KarimM-MSW/Wuerfel_Projekt/README.md

# Hardware
Siehe: [Fusion 360](https://mymsw.autodesk360.com/g/projects/20250221882367826/data/dXJuOmFkc2sud2lwcHJvZDpmcy5mb2xkZXI6Y28uNGE5Rl9pY0hUby1hNFgzeldFdEFYUQ==)
