KarimM-MSW/Wuerfel_Projekt/Projekt Wuerfel/Drahtzugliste.pdf

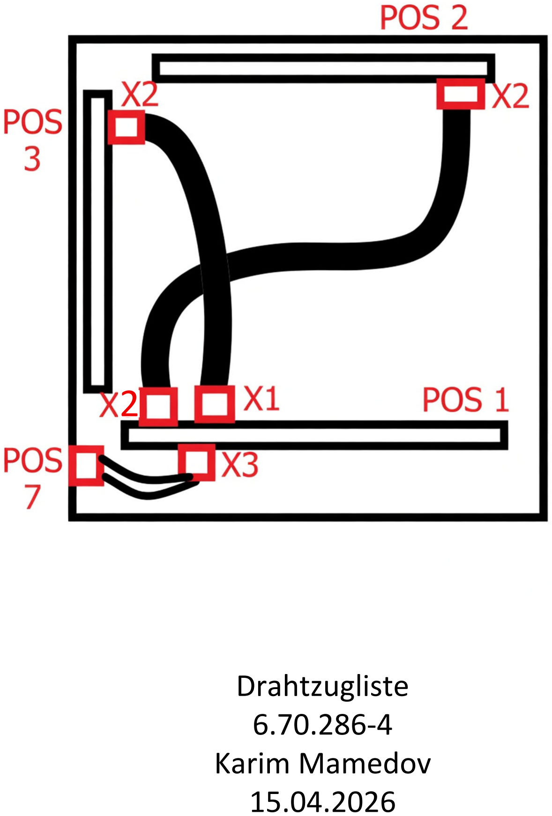
[picture p1: page 1]

Drahtzugliste
6.70.286-4
Karim Mamedov
15.04.2026

2
