KarimM-MSW/Wuerfel_Projekt/Projekt Wuerfel/Wuerfel Zusammenbau KM.pdf

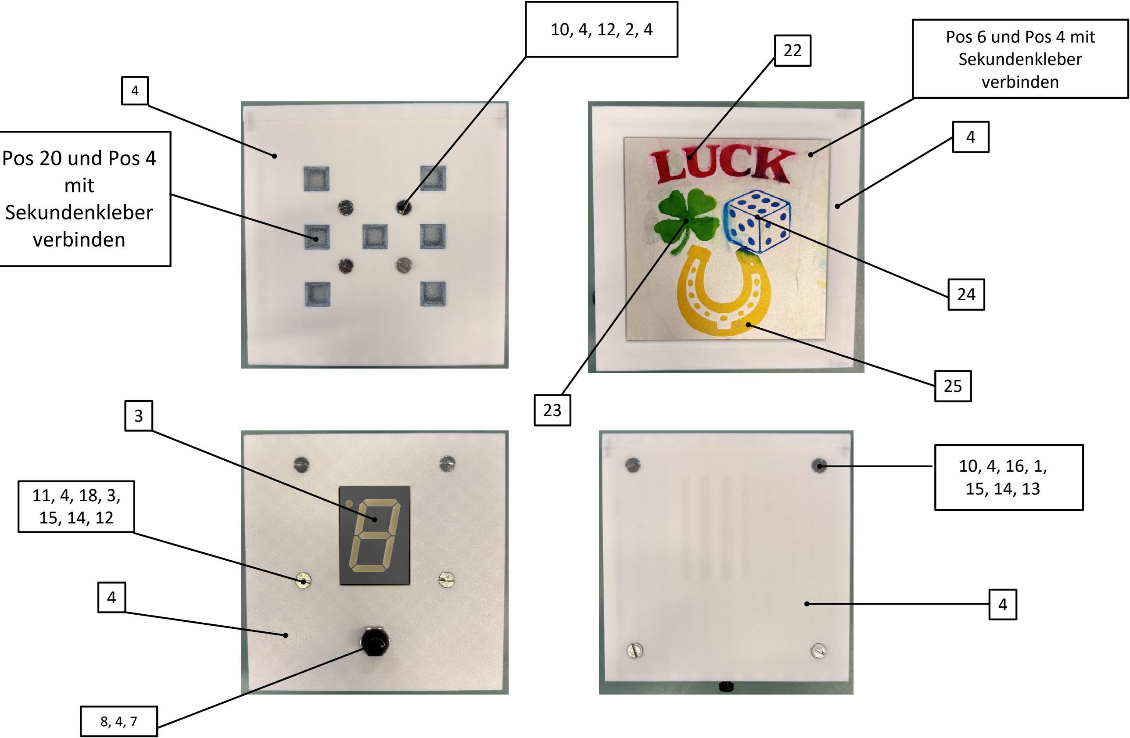
[picture p2: figure]
Pos 20 und Pos 4 mit Sekundenkleber verbinden; Pos 6 und Pos 4 mit Sekundenkleber verbinden
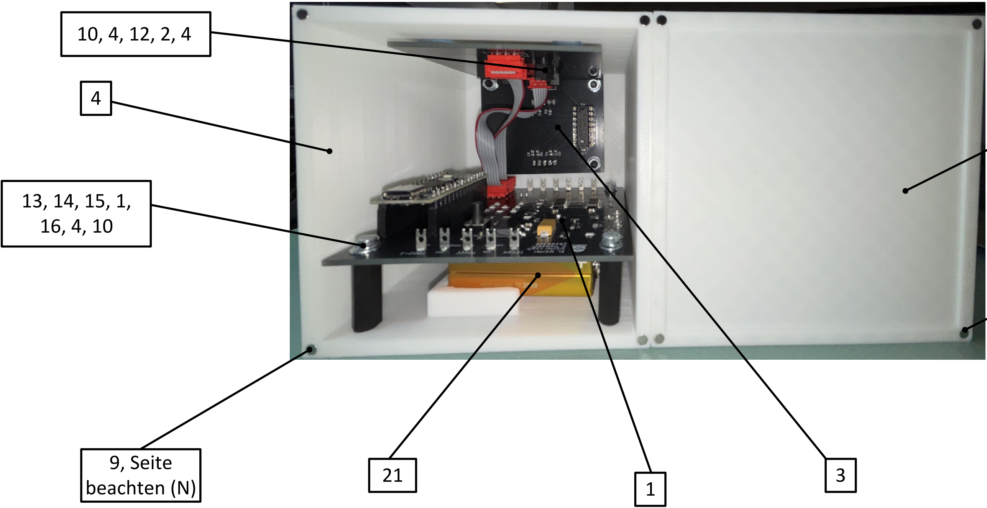
[picture p3: figure]
21 9, Seite beachten (N)

5

9, Seite
beachten (S)

# Zeichnung Zusammenbau

6.70.150-4

# Karim Mamedov

15.04.2026
