KarimM-MSW/Wuerfel_Projekt/Projekt Wuerfel/Luck.png

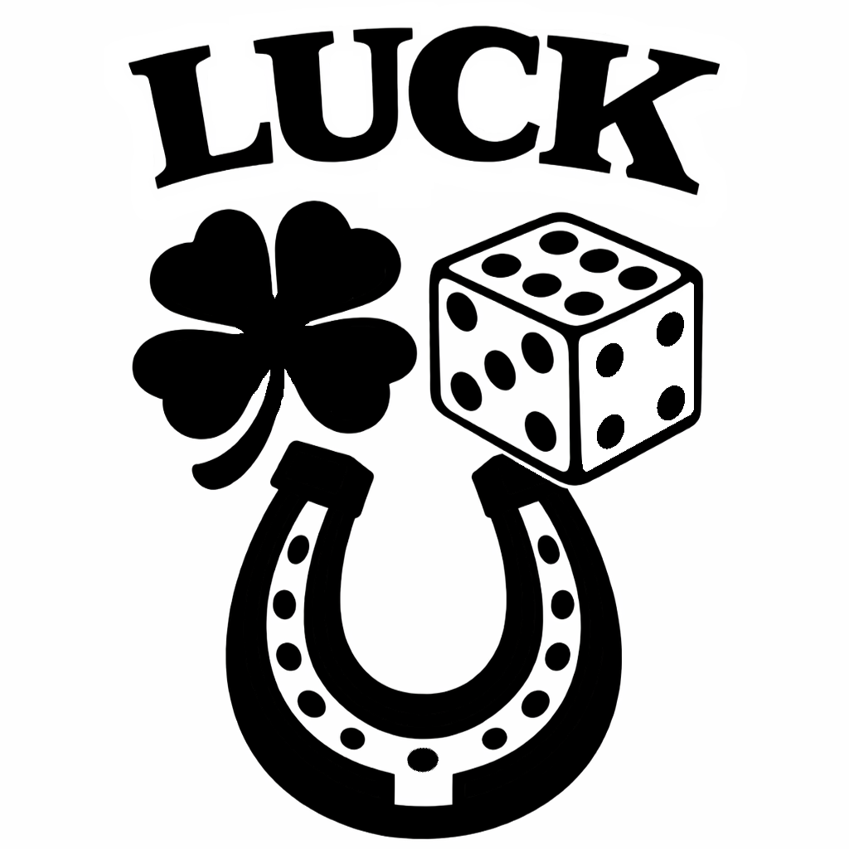
Projekt Wuerfel/Luck.png
