KarimM-MSW/Wuerfel_Projekt/Projekt Wuerfel/Mech. Zeichnung Deckel KM.jpg

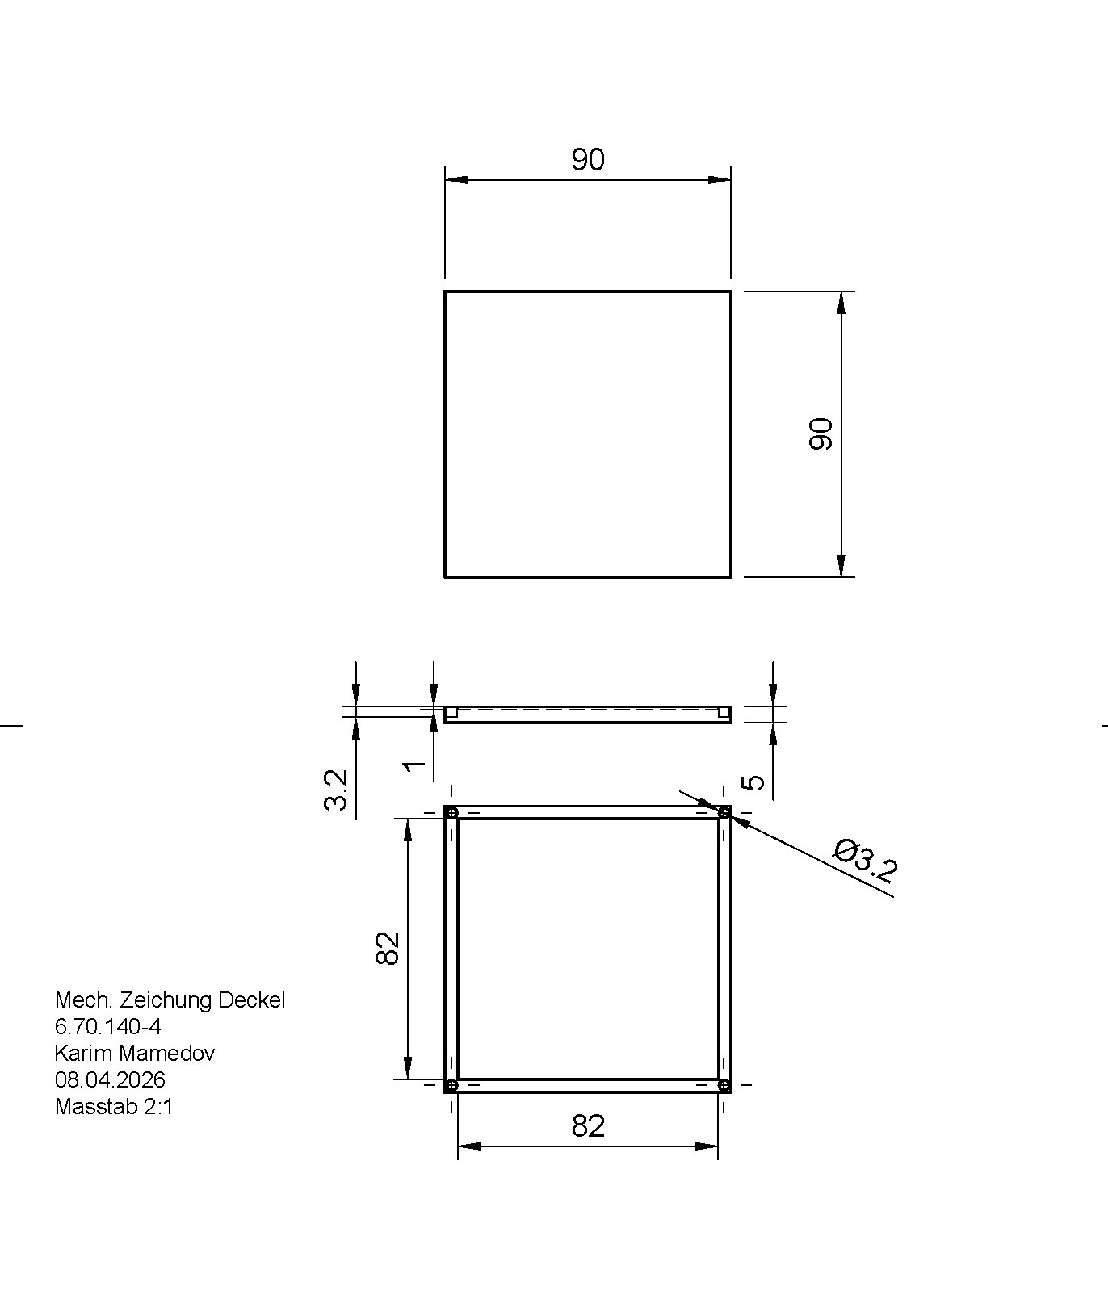
Projekt Wuerfel/Mech. Zeichnung Deckel KM.jpg
