KarimM-MSW/Wuerfel_Projekt/Projekt Wuerfel/Mech.Zeichnung Gehause KM.jpg

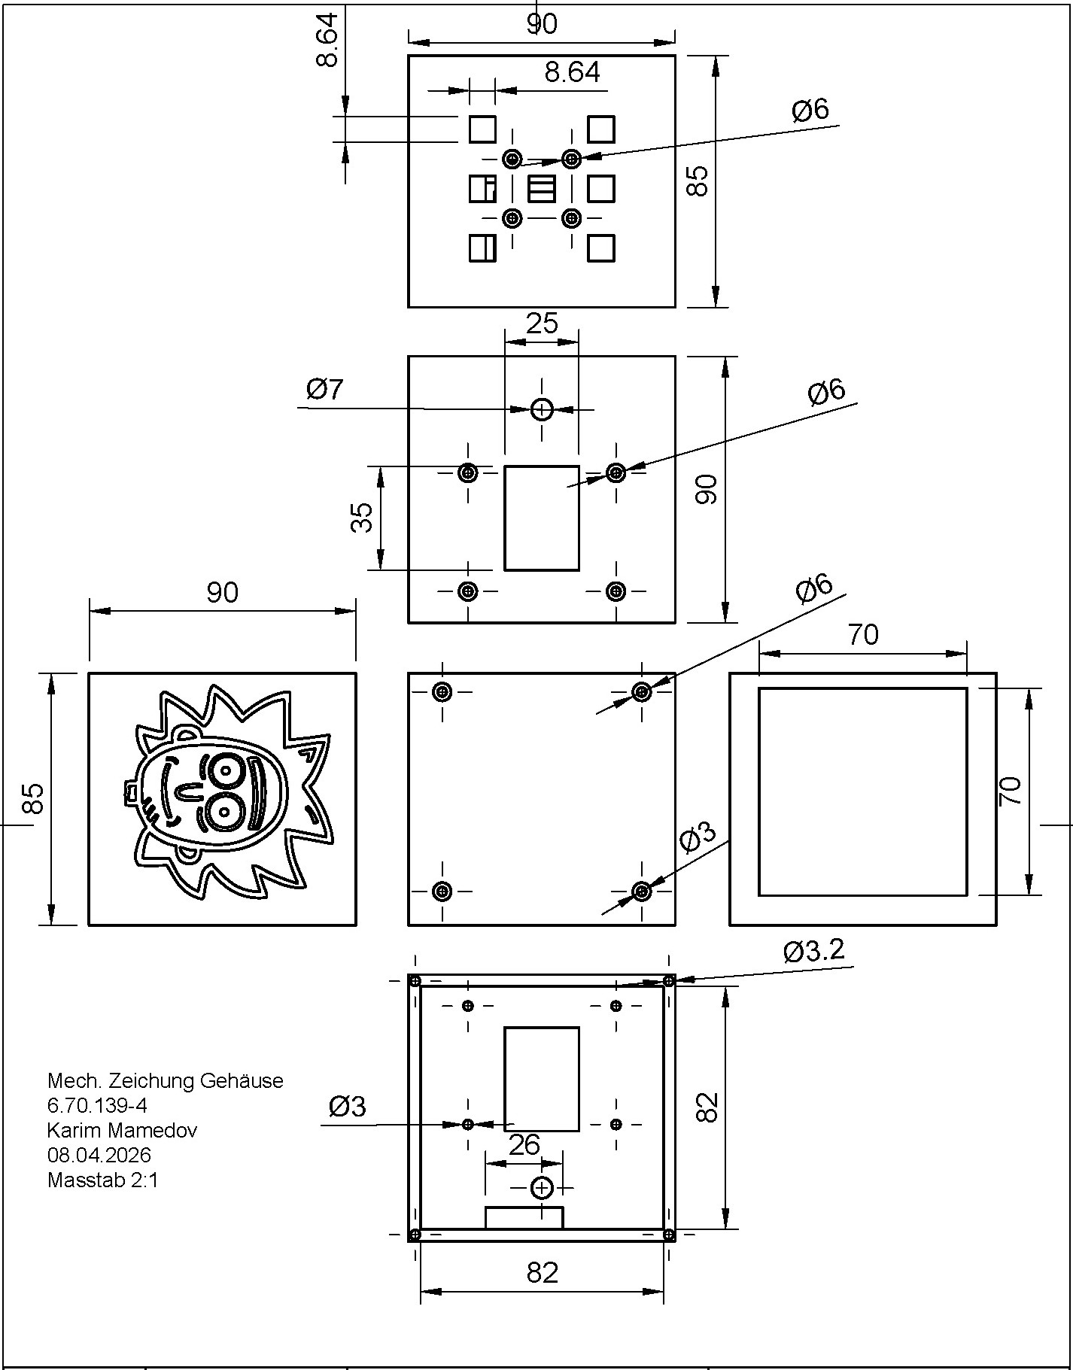
Projekt Wuerfel/Mech.Zeichnung Gehause KM.jpg
