KarimM-MSW/Wuerfel_Projekt/Projekt Wuerfel/Stückliste Zusammenbau.docx

Produkt Elektronischer Würfel | | | | | | Nummer | | Index | Mikro | Blatt/Total 1/1
Baugruppe Zusammenbau | | | | | | Stück | | Termin | | Auftrag
Erstellt 08.04.2026 Karim Mamedov | | Geändert | | | | Felder leer lassen, wird durch PPS ausgefüllt.
Geprüft | | Geprüft
Stk. | Gegenstand/Wert Zchng.Nr. | | Pos.Nr. | Zeile | Bestell-Nr./Material Lieferant | | | | | | C
1 | Mainboard bestückt | | 1 | 1 | Baugruppe A AE1 | | | | | | NT
1 | RGB board bestückt | | 2 | 2 | Baugruppe B AE1 | | | | | | NT
1 | 7Seg board bestückt | | 3 | 3 | Baugruppe C AE1 | | | | | | NT
| | | | 4
1 | Würfel Gehäuse | | 4 | 5 | AE1 | | | | | | NT
1 | Würfel Deckel | | 5 | 6 | AE1 | | | | | | NT
| | | | 7
1 | Alu platte mit Bild 69x69x0.5 mm | | 6 | 8 | AE1 | | | | | | NT
| | | | 9
1 | Taster | | 7 | 10 | AE1 | | | | | | NT
1 | Taster Mutter | | 8 | 11 | AE1 | | | | | | NT
| | | | 12
8 | Magnet Ø 3 × 3 mm | | 9 | 13 | AE1 | | | | | | NT
| | | | 14
8 | Senkschraube M3x12 | | 10 | 15 | AE1 | | | | | | NT
4 | Senkschraube M3x5 | | 11 | 16 | AE1 | | | | | | NT
12 | Mutter M3 | | 12 | 17 | AE1 | | | | | | NT
4 | Zylinderschraube M3x10 | | 13 | 18 | AE1 | | | | | | NT
8 | Federring M3 | | 14 | 19 | AE1 | | | | | | NT
8 | Unterlagscheibe M3 | | 15 | 20 | AE1 | | | | | | NT
4 | Abstandshalter M3x20 | | 16 | 21 | AE1 | | | | | | NT
4 | Abstandshalter M3x6 | | 17 | 22 | AE1 | | | | | | NT
4 | Abstandshalter M3x5 Innen/Aussen | | 18 | 23 | AE1 | | | | | | NT
| | | | 24
2 | Flachbandkabel 6 Pol 2xWR-MM Male 7cm | | 19 | 25 | AE1 | | | | | | NT
| | | | 26
7 | LED Diffusor 8.5x8.5x4 mm | | 20 | 27 | AE1 | | | | | | NT
| | | | 28
1 | Batterie 9V Block | | 21 | 29 | AE1 | | | | | | NT
1 | Farbe Rot 72 | | 22 | 30 | AE1 | | | | | | NT
1 | Farbe Grün 54 | | 23 | 31 | AE1 | | | | | | NT
1 | Farbe Blau 44 | | 24 | 32 | AE1 | | | | | | NT
1 | Farbe Gelb 62 | | 25 | 33 | AE1 | | | | | | NT
*=Preis anfragen Stückliste.doc | | | EF=Eigenfabrikat BT=Bestellteil PA=Physikartikel NT=Normteil RM=Rohmaterial
