KarimM-MSW/Wuerfel_Projekt/Projekt Wuerfel/A/Stückliste Mainboard.docx

Produkt Elektronischer Würfel | | | | | | Nummer | Index | Mikro | Blatt/Total 1/2
Baugruppe Mainboard A | | | | | | Stück | Termin | | Auftrag
Erstellt 05.03.2026 Karim Mamedov | | Geändert | | | | Felder leer lassen, wird durch PPS ausgefüllt.
Geprüft | | Geprüft
Stk. | Gegenstand/Wert Zchng.Nr. | | Pos.Nr. | Zeile | Bestell-Nr./Material Lieferant | | | | | C
1 | Schema Baugr A 6.70.136-4 | | | 1
1 | Bestückungsplan 6.70.137-4 | | | 2
1 | Bearbeitungsplan 6.70.138-4 | | | 3
| | | | 4
1 | Mainboard | | 1 | 5 | JLCPCB | | | | | BT
| | | | 6
5 | SMD Kondensator 100nF, 0805 | | C1-C3, C7, C8 | 7 | AE1 | | | | | NT
1 | SMD-Tantal - Kondensator 7343 100uF 16V | | C4 | 8 | AE1 | | | | | NT
2 | SMD Kondensator 4.7uF, 0805 | | C5, C6 | 9 | AE1 | | | | | NT
| | | | 10
1 | Arduino Nano | | K1 | 11 | AE1 | | | | | NT
1 | IC 4-bit Zähler 4161D SO16 | | K2 | 12 | AE1 | | | | | NT
1 | SMD-IC 74132D (Quad 2-input NAND schmitt trigger) SO14 | | K3 | 13 | AE1 | | | | | NT
| | | | 14
7 | SMD-LED ROT 0805 | | P1-P7 | 15 | AE1 | | | | | NT
| | | | 16
1 | SMD-PNP-Transistor BC807 SOT23 | | Q1 | 17 | AE1 | | | | | NT
1 | SMD-NPN-Transistor BC817 SOT23 | | Q2 | 18 | AE1 | | | | | NT
| | | | 19
2 | SMD-Widerstand 22kΩ/0,1W/1% 0805 | | R1, R2 | 20 | AE1 | | | | | NT
1 | SMD-Widerstand 390kΩ/0,1W/1% 0805 | | R3 | 21 | AE1 | | | | | NT
2 | SMD-Widerstand 470Ω/0,1W/1% 0805 | | R4, R9 | 22 | AE1 | | | | | NT
1 | SMD-Widerstand 1MΩ/0,1W/1% 0805 | | R5 | 23 | AE1 | | | | | NT
1 | SMD-Widerstand 750kΩ/0,1W/1% 0805 | | R6 | 24 | AE1 | | | | | NT
1 | SMD-Widerstand 10kΩ/0,1W/1% 0805 | | R7 | 25 | AE1 | | | | | NT
1 | SMD-Widerstand 68Ω/0,1W/1% 0805 | | R8 | 26 | AE1 | | | | | NT
2 | SMD-Widerstand 220Ω/0,1W/1% 0805 | | R10, R11 | 27 | AE1 | | | | | NT
4 | SMD-Diode 1N4148 SOD123 | | R12, R13, R14, R18 | 28 | AE1 | | | | | NT
1 | SMD-Diode 1N4007 SOD123 | | R15 | 29 | AE1 | | | | | NT
1 | SMD-Zener-Diode 5.1V SOD323 | | R17 | 30 | AE1 | | | | | NT
| | | | 31
1 | SMD-Taste | | S1 | 32 | AE1 | | | | | NT
| | | | 33

Produkt Elektronischer Würfel | | | | | | Nummer | | Index | Mikro | Blatt/Total 2/2
Baugruppe Mainboard A | | | | | | Stück | | Termin | | Auftrag
Erstellt 05.03.2026 Karim Mamedov | | Geändert | | | | Felder leer lassen, wird durch PPS ausgefüllt.
Geprüft | | Geprüft
Stk. | Gegenstand/Wert Zchng.Nr. | | Pos.Nr. | Zeile | Bestell-Nr./Material Lieferant | | | | | | C
1 | Spannungsregler LM7805 TO-252 | | T1 | 34 | AE1 | | | | | | NT
| | | | 35
2 | WR_MM Female Connector 6.90367E+11 | | X1, X2 | 36 | AE1 | | | | | | NT
1 | 2-Pol-Buchse B2B-XH-A | | X3 | 37 | AE1 | | | | | | NT
1 | Einzelkontakt 9V Female | | X4 | 38 | AE1 | | | | | | NT
1 | Einzelkontakt 9V Male | | X5 | 39 | AE1 | | | | | | NT
14 | Lötstift 1002M SA0785 | | X6 – X19 | 40 | AE1 | | | | | | NT
2 | Sockel 15 Pin | | X20, X21 | 41 | AE1 | | | | | | NT
| | | | 42
| | | | 43
| | | | 44
| | | | 45
| | | | 46
| | | | 47
| | | | 48
| | | | 49
| | | | 50
| | | | 51
| | | | 52
| | | | 53
| | | | 54
| | | | 55
| | | | 56
| | | | 57
| | | | 58
| | | | 59
| | | | 60
| | | | 61
| | | | 62
| | | | 63
| | | | 64
*=Preis anfragen Stückliste.doc | | | EF=Eigenfabrikat BT=Bestellteil PA=Physikartikel NT=Normteil RM=Rohmaterial
