KarimM-MSW/Wuerfel_Projekt/Projekt Wuerfel/B/Stückliste RGBs.docx

Produkt Elektronischer Würfel | | | | | | Nummer | | Index | Mikro | Blatt/Total 1/1
Baugruppe Würfel RGBs B | | | | | | Stück | | Termin | | Auftrag
Erstellt 06.03.2026 Karim Mamedov | | Geändert | | | | Felder leer lassen, wird durch PPS ausgefüllt.
Geprüft | | Geprüft
Stk. | Gegenstand/Wert Zchng.Nr. | | Pos.Nr. | Zeile | Bestell-Nr./Material Lieferant | | | | | | C
1 | Schema Baugr B 6.70.279-4 | | | 1 | AE1 | | | | | | NT
1 | Bestückungsplan 6.70.280-4 | | | 2 | AE1 | | | | | | NT
1 | Bearbeitungsplan 6.70.281-4 | | | 3 | AE1 | | | | | | NT
| | | | 4
1 | Print Würfel RGBs | | 1 | 5 | JLCPCB | | | | | | BT
| | | | 6
7 | SMD Kondensator 100nF, 0805 | | C1-C7 | 7 | AE1 | | | | | | NT
| | | | 8
7 | Neopixel WS2812B RGB LED | | P1-P7 | 9 | AE1 | | | | | | NT
| | | | 10
1 | WR_MM Female Connector 6.90367E+11 | | X2 | 11 | AE1 | | | | | | NT
| | | | 12
| | | | 13
| | | | 14
| | | | 15
| | | | 16
| | | | 17
| | | | 18
| | | | 20
| | | | 21
| | | | 22
| | | | 23
| | | | 24
| | | | 25
| | | | 26
| | | | 27
| | | | 28
| | | | 29
| | | | 30
| | | | 31
| | | | 32
*=Preis anfragen Stückliste.doc | | | EF=Eigenfabrikat BT=Bestellteil PA=Physikartikel NT=Normteil RM=Rohmaterial
