KarimM-MSW/Wuerfel_Projekt/Projekt Wuerfel/C/Stückliste 7Seg.docx

Produkt Elektronischer Würfel | | | | | | Nummer | | Index | Mikro | Blatt/Total 1/1
Baugruppe Würfel 7 Segment Anzeige C | | | | | | Stück | | Termin | | Auftrag
Erstellt 06.03.2026 Karim Mamedov | | Geändert | | | | Felder leer lassen, wird durch PPS ausgefüllt.
Geprüft | | Geprüft
Stk. | Gegenstand/Wert Zchng.Nr. | | Pos.Nr. | Zeile | Bestell-Nr./Material Lieferant | | | | | | C
1 | Schema Baugr C 6.70.287-4 | | | 1
1 | Bestückungsplan 6.70.288-4 | | | 2
1 | Bearbeitungsplan 6.70.289-4 | | | 3
| | | | 4
1 | Print Würfel 7 Segment | | 1 | 5 | JLCPCB | | | | | | BT
| | | | 6
1 | SMD Kondensator 100nF, 0805 | | C1 | 7 | AE1 | | | | | | NT
| | | | 8
1 | 7-Seg Anzeige SC10-21EWA | | P1 | 9 | 604-SC10-21EWA MOUSER | | | | | | BT
| | | | 10
7 | SMD-Widerstand 270Ω/0,1W/1% 0805 | | R1-R7 | 11 | AE1 | | | | | | NT
| | | | 12
1 | 8-bit SHIFT REGISTER, 74HC595, DIL16 | | K1 | 13 | AE1 | | | | | | NT
| | | | 14
1 | WR_MM Female Connector 6.90367E+11 | | X2 | 15 | AE1 | | | | | | NT
| | | | 16
| | | | 17
| | | | 18
| | | | 20
| | | | 21
| | | | 22
| | | | 23
| | | | 24
| | | | 25
| | | | 26
| | | | 27
| | | | 28
| | | | 29
| | | | 30
| | | | 31
| | | | 32
*=Preis anfragen Stückliste.doc | | | EF=Eigenfabrikat BT=Bestellteil PA=Physikartikel NT=Normteil RM=Rohmaterial
