KarimM-MSW/Wuerfel_Projekt/Projekt Wuerfel/Prototyp Wurfel Gehause v1.3mf

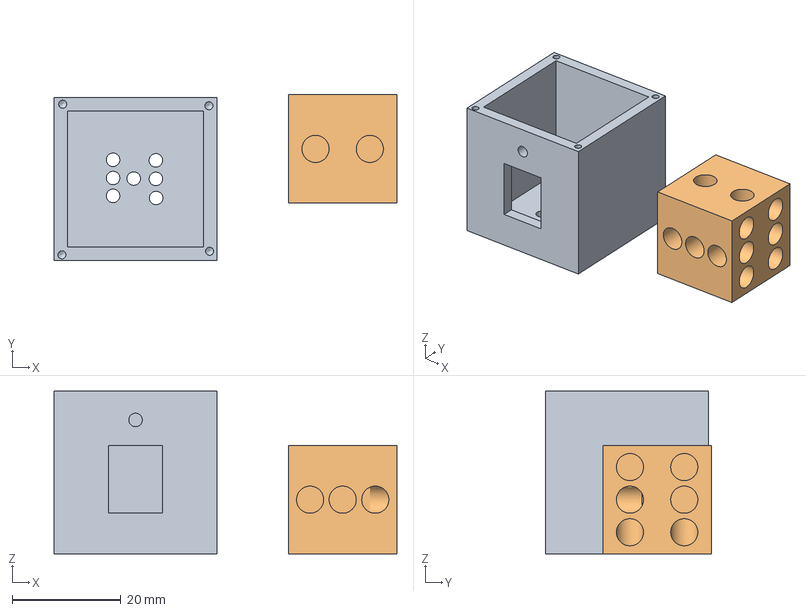
[picture p7: CAD file, 2026-07-03]
Projekt Wuerfel/Prototyp Wurfel Gehause v1.3mf
63.1 x 30.5 x 30.0 mm
Körper2
Körper4
