KarimM-MSW/Wuerfel_Projekt/Projekt Wuerfel/Mech. Zeichnung Deckel KM.pdf

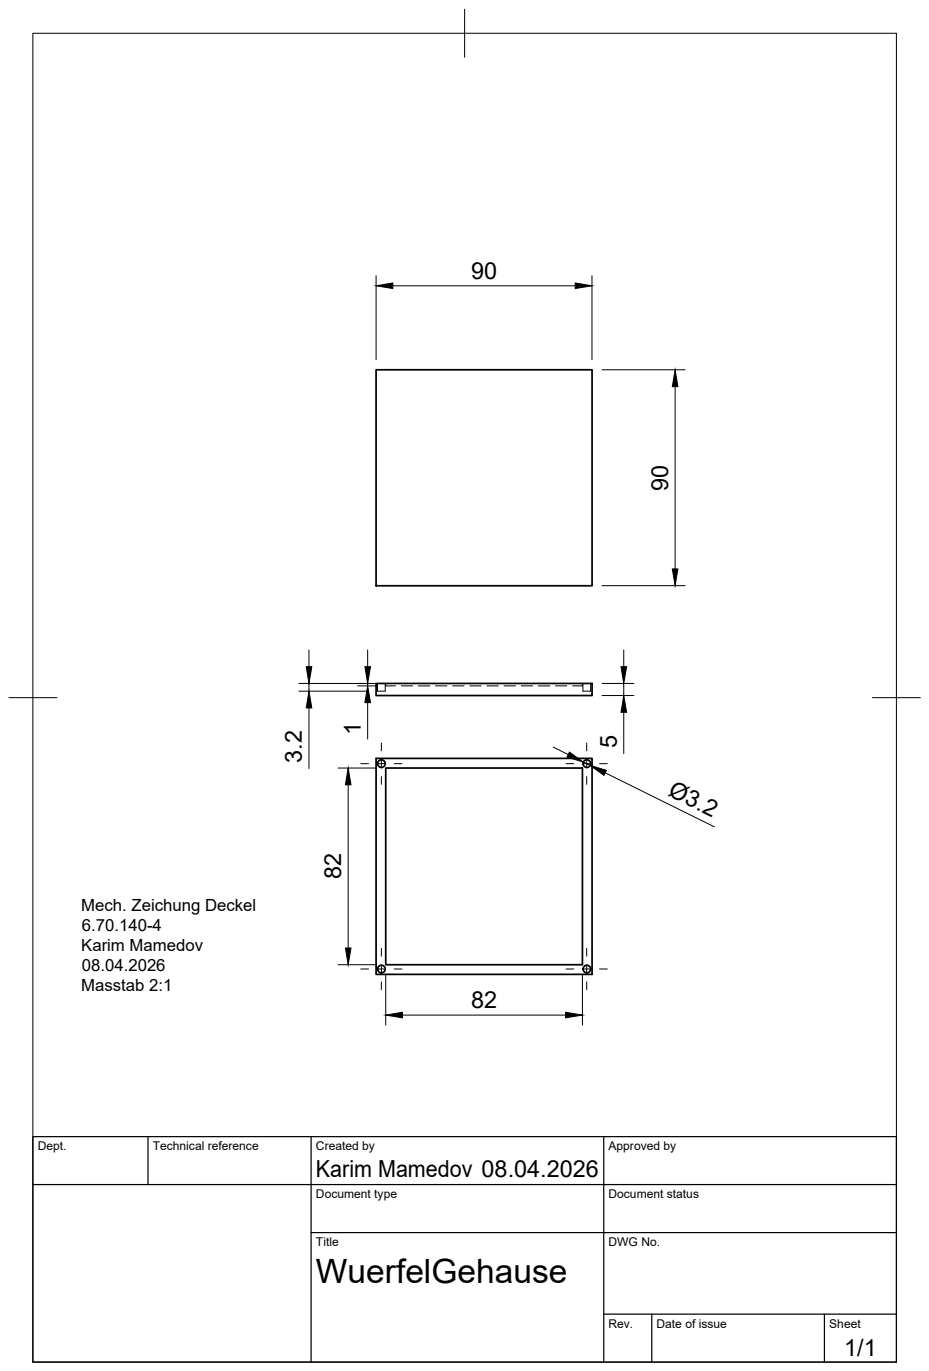
[picture p8: page 1]
Mech. Zeichung Deckel; Karim Mamedov; Masstab 2:1

Dept. | Technical reference | Created by Karim Mamedov 08.04.2026 | Approved by

Document type | Document status

Title WuerfelGehause | DWG No.

Rev. | Date of issue | Sheet 1/1
